AlpenglowIndustries/Alpenglow_SMTGarden_PCB/Alpenglow_SMTGarden_PCB/SMTSolderIntro.png

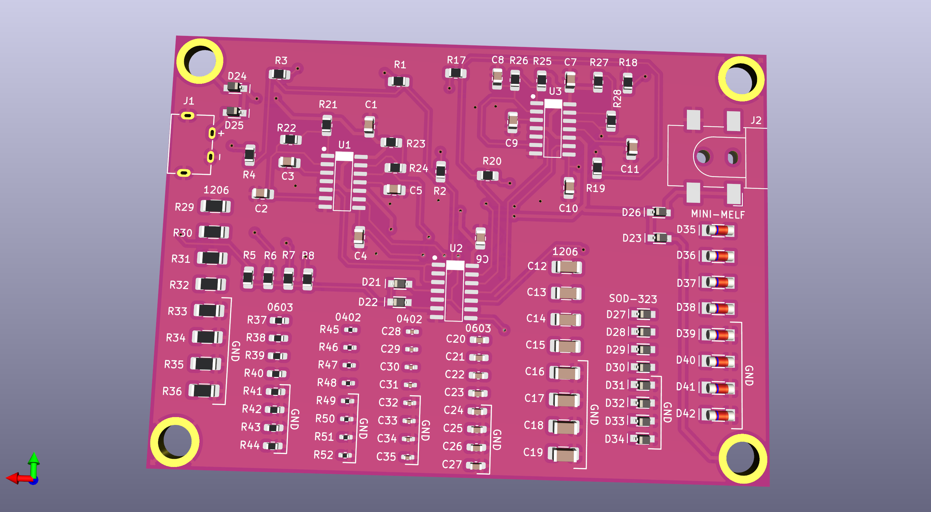
Alpenglow_SMTGarden_PCB/SMTSolderIntro.png
