AlpenglowIndustries/Alpenglow_SMTGarden_PCB/Alpenglow_SMTGarden_PCB/SMTSolderIntrofront.png

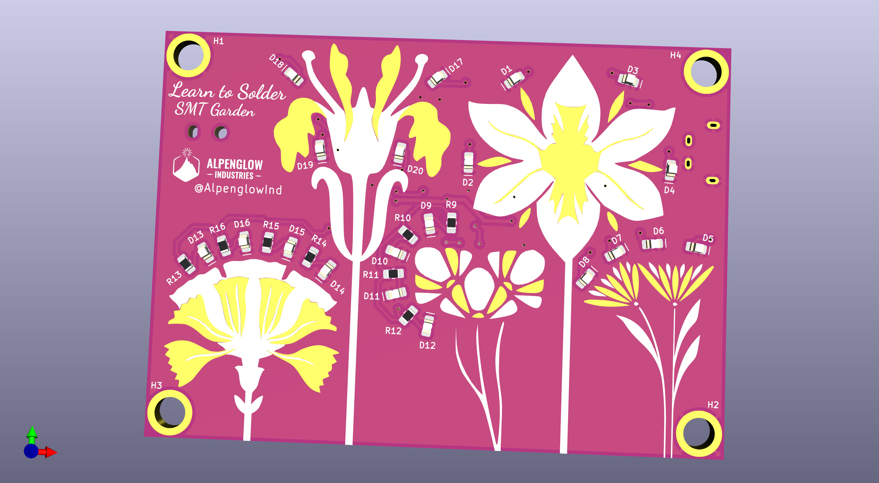
Alpenglow_SMTGarden_PCB/SMTSolderIntrofront.png
