AlpenglowIndustries/Alpenglow_SMTGarden_PCB/README.md

# Alpenglow_SMT_Soldering_PCB
A fun kit with lots of blinky lights and 555 timers that gives you lots of practice with different sizes of surface mount components
