AlpenglowIndustries/Alpenglow_SMTGarden_PCB/Artwork/My Exports/04Flower.png

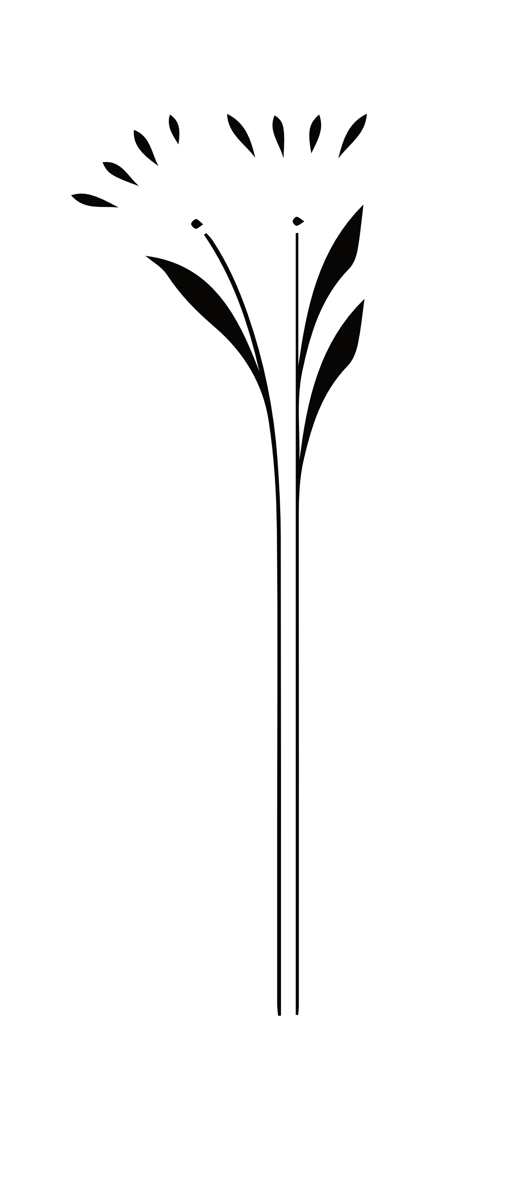
Artwork/My Exports/04Flower.png
