AlpenglowIndustries/Alpenglow_SMTGarden_PCB/Artwork/My Exports/04Inside.png

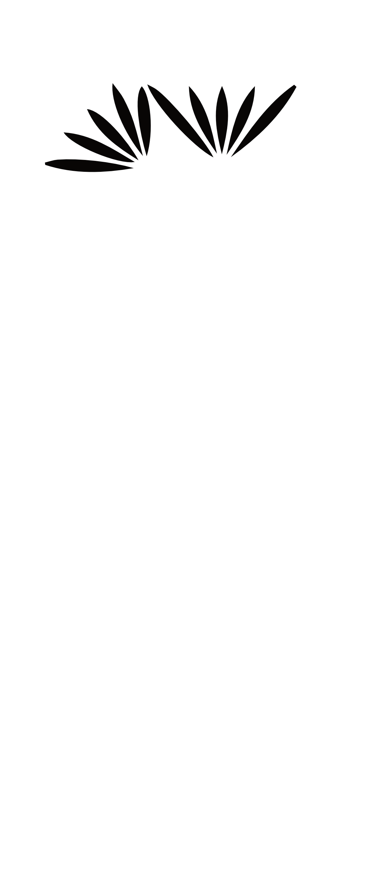
Artwork/My Exports/04Inside.png
