AlpenglowIndustries/Alpenglow_SMTGarden_PCB/Artwork/PNG/pngArtboard 2.png

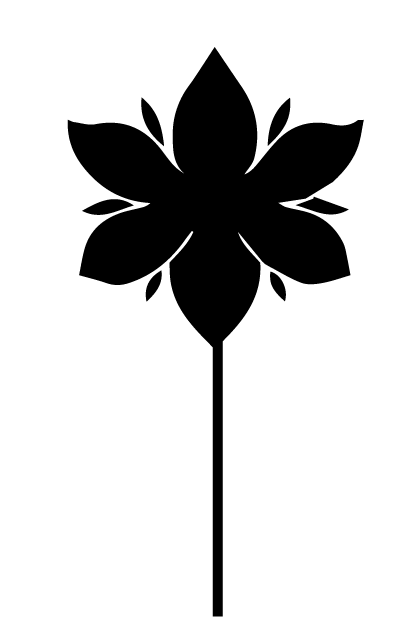
Artwork/PNG/pngArtboard 2.png
