AlpenglowIndustries/Alpenglow_SMTGarden_PCB/Artwork/PNG/pngArtboard 2_1.png

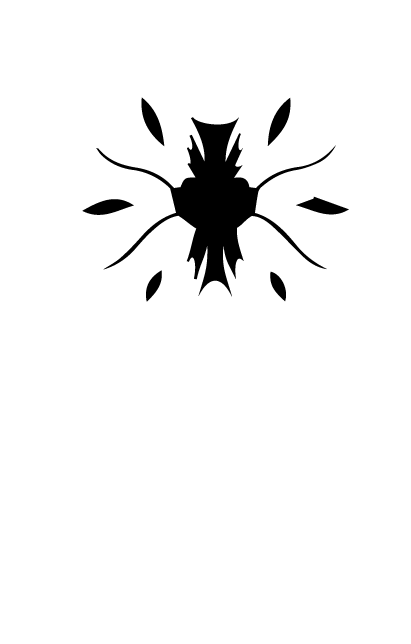
Artwork/PNG/pngArtboard 2_1.png
