AlpenglowIndustries/Alpenglow_SMTGarden_PCB/Artwork/PNG/pngArtboard 9.png

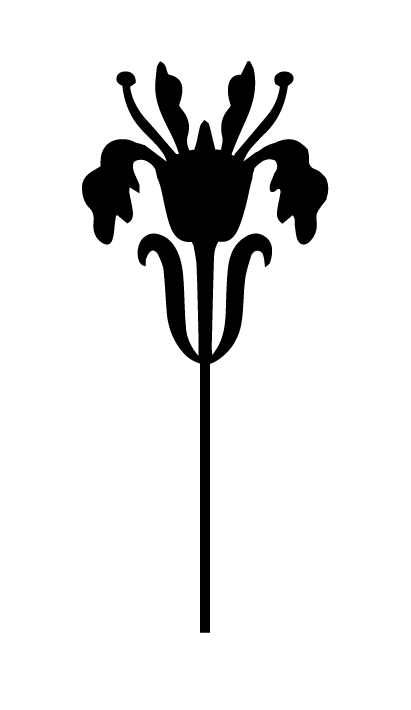
Artwork/PNG/pngArtboard 9.png
