AlpenglowIndustries/Alpenglow_SMTGarden_PCB/Artwork/PNG/pngArtboard 9_1.png

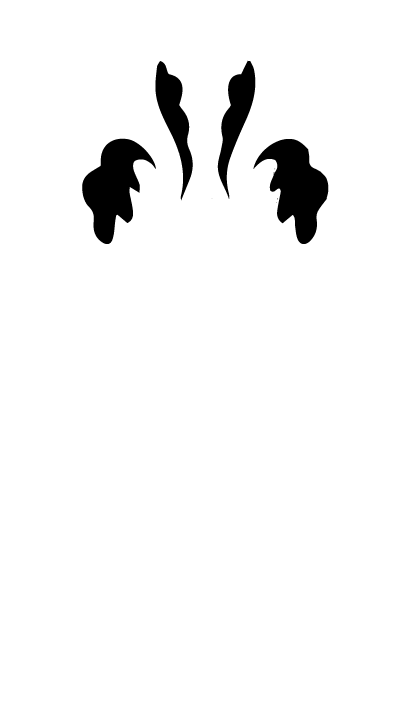
Artwork/PNG/pngArtboard 9_1.png
