AlpenglowIndustries/Alpenglow_SMTGarden_PCB/Artwork/PNG/pngArtboard 9_2 crop.png

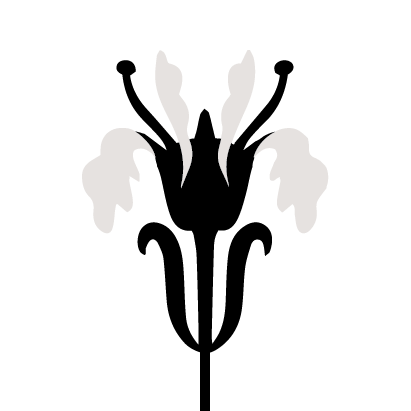
Artwork/PNG/pngArtboard 9_2 crop.png
