AlpenglowIndustries/Alpenglow_SMTGarden_PCB/Artwork/PNG/pngArtboard 9_3.png

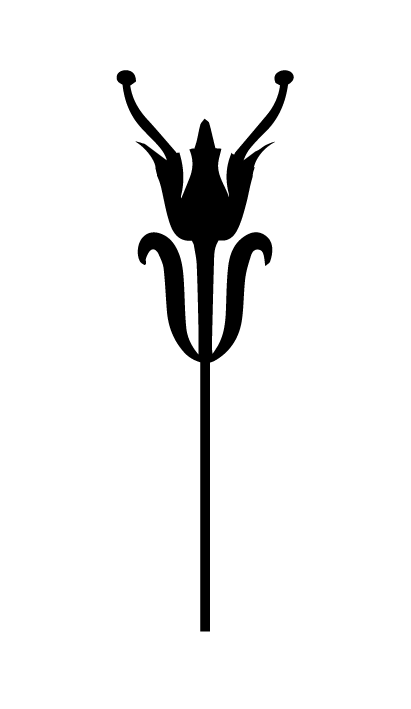
Artwork/PNG/pngArtboard 9_3.png
