AlpenglowIndustries/Alpenglow_SMTGarden_PCB/Artwork/PNG/pngArtboard 13.png

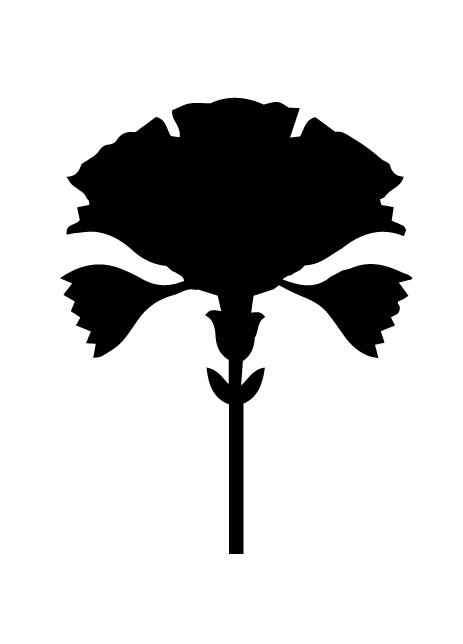
Artwork/PNG/pngArtboard 13.png
