AlpenglowIndustries/Alpenglow_SMTGarden_PCB/Artwork/PNG/pngArtboard 13_1.png

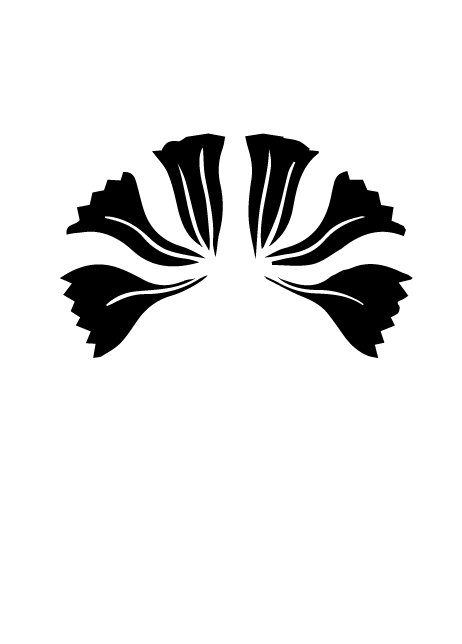
Artwork/PNG/pngArtboard 13_1.png
