AlpenglowIndustries/Alpenglow_SMTGarden_PCB/Artwork/PNG/pngArtboard 13_2.png

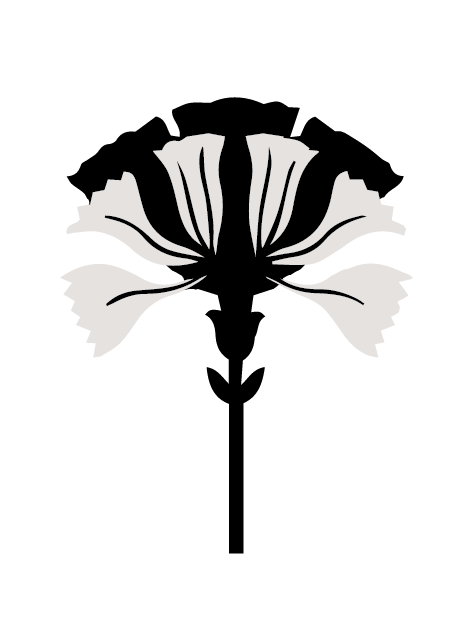
Artwork/PNG/pngArtboard 13_2.png
