AlpenglowIndustries/Alpenglow_SMTGarden_PCB/Artwork/PNG/pngArtboard 17.png

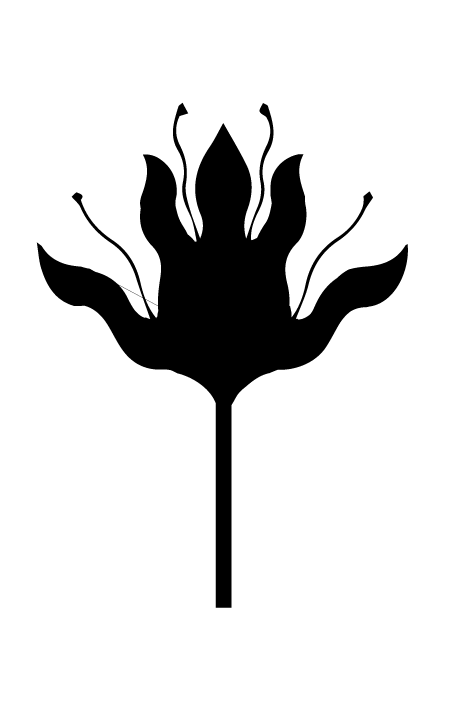
Artwork/PNG/pngArtboard 17.png
