AlpenglowIndustries/Alpenglow_SMTGarden_PCB/Artwork/PNG/pngArtboard 17_1.png

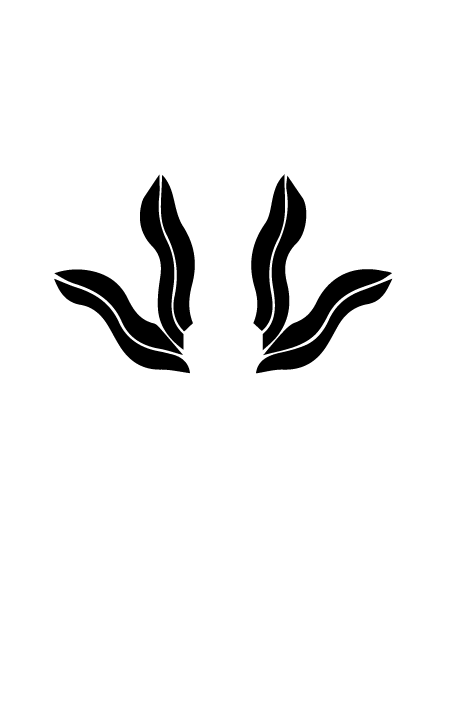
Artwork/PNG/pngArtboard 17_1.png
