AlpenglowIndustries/Alpenglow_SMTGarden_PCB/Artwork/PNG/pngArtboard 21.png

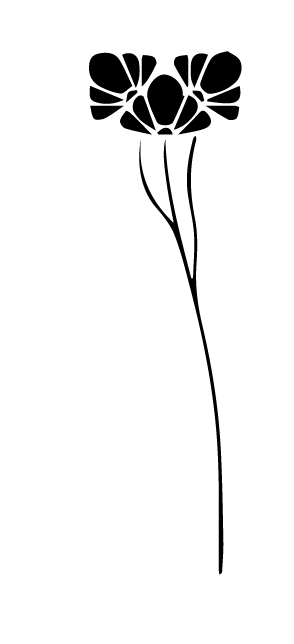
Artwork/PNG/pngArtboard 21.png
