AlpenglowIndustries/Alpenglow_SMTGarden_PCB/Artwork/PNG/pngArtboard 21_1.png

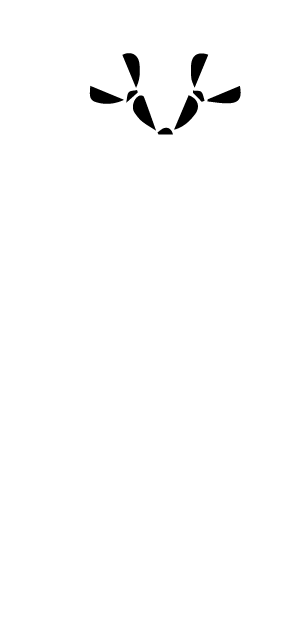
Artwork/PNG/pngArtboard 21_1.png
