AlpenglowIndustries/Alpenglow_SMTGarden_PCB/Artwork/Practice Stalks Dancing.png

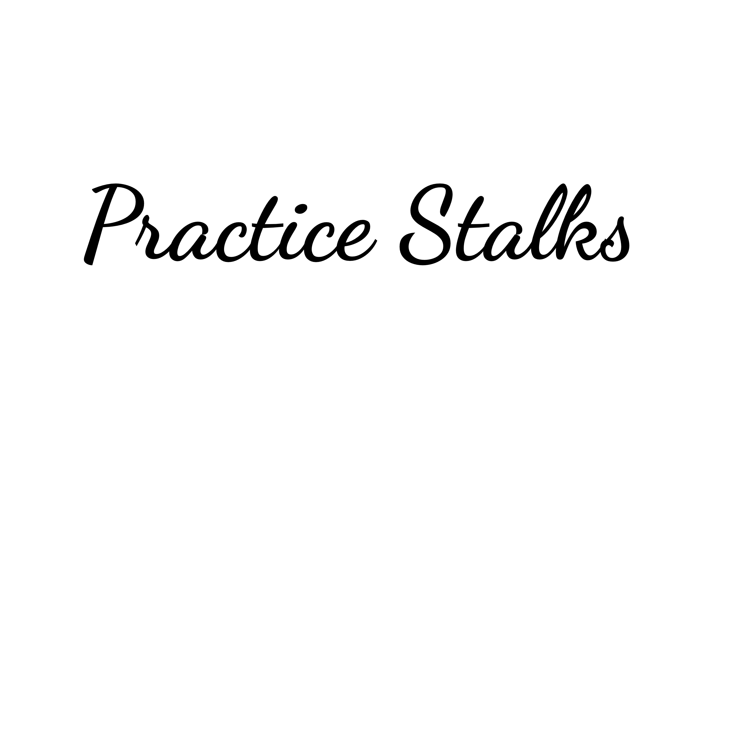
Artwork/Practice Stalks Dancing.png
