AlpenglowIndustries/Alpenglow_SMTGarden_PCB/Artwork/SMT Garden Dancing.png

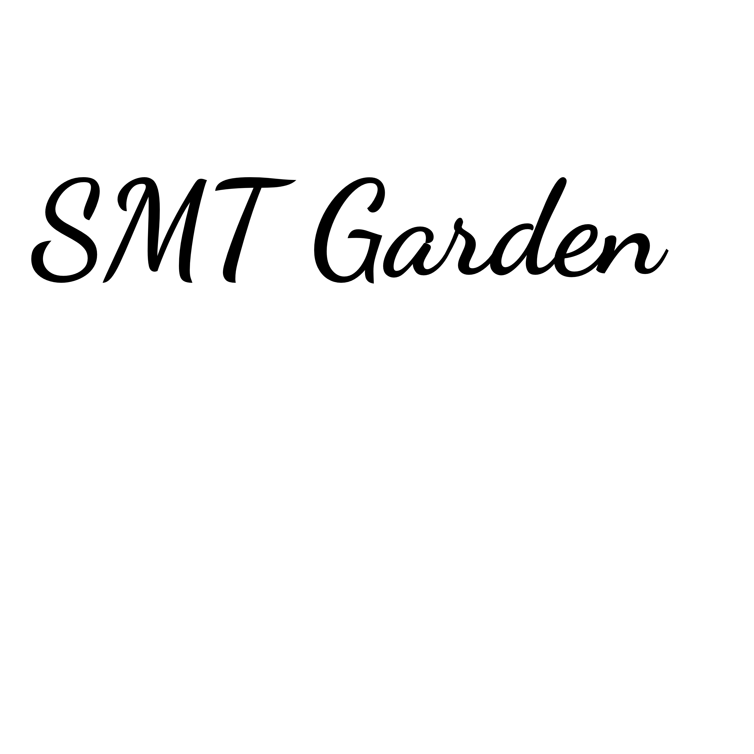
Artwork/SMT Garden Dancing.png
