AlpenglowIndustries/Alpenglow_SMTGarden_PCB/Screenshots/Back2.JPG

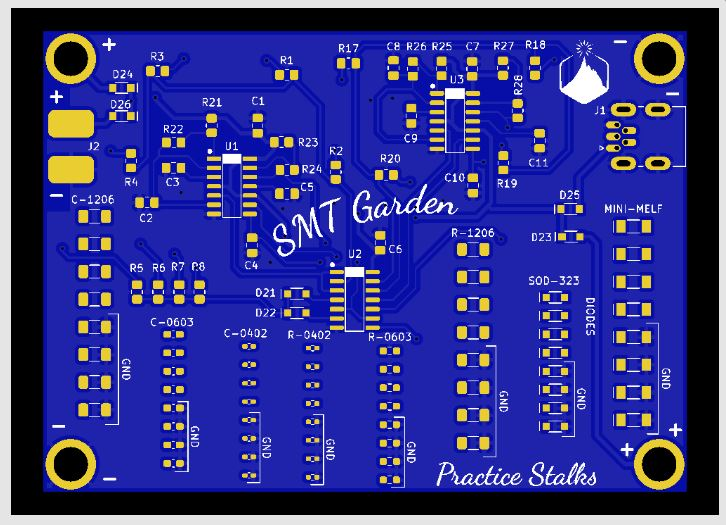
Screenshots/Back2.JPG
