AlpenglowIndustries/Alpenglow_SMTGarden_PCB/Screenshots/Front2.JPG

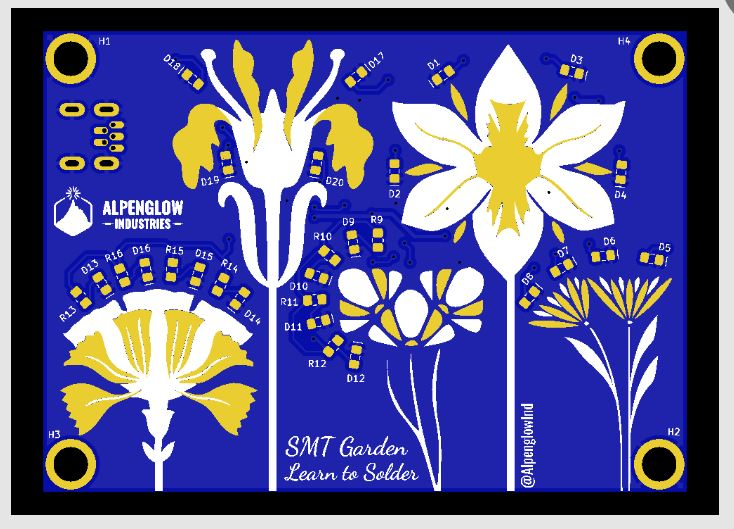
Screenshots/Front2.JPG
