AlpenglowIndustries/Alpenglow_SMTGarden_PCB/Screenshots/Front.JPG

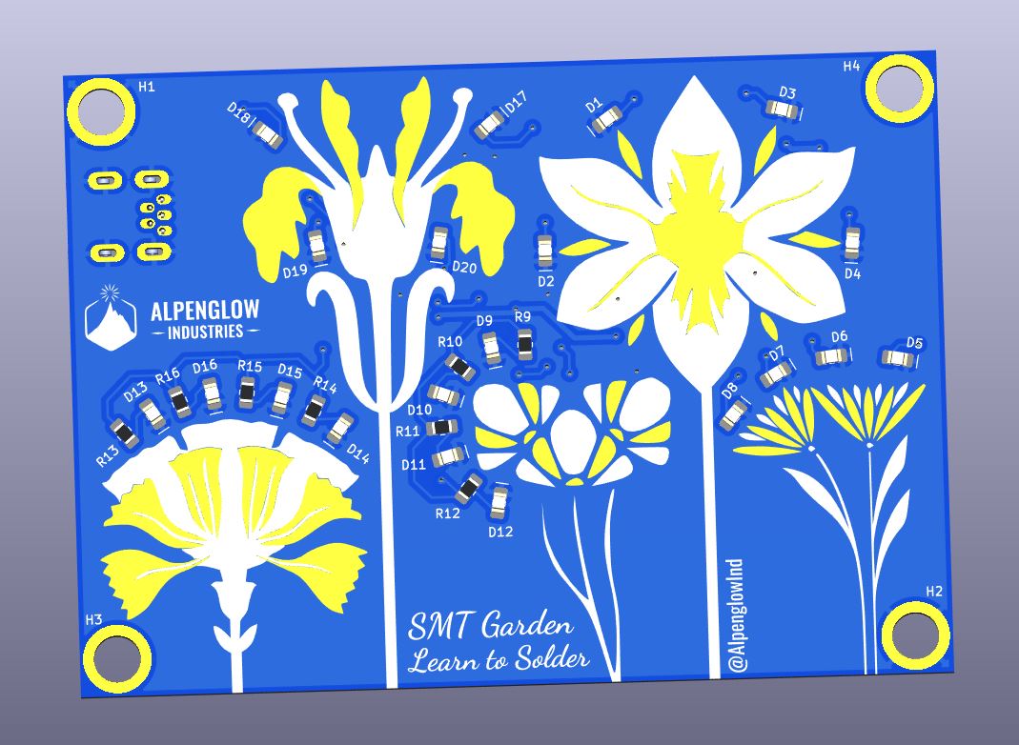
Screenshots/Front.JPG
