AlpenglowIndustries/Alpenglow_SMTGarden_PCB/Alpenglow_SMTGarden_PCB/AlpenglowSMTGarden Schematic.pdf

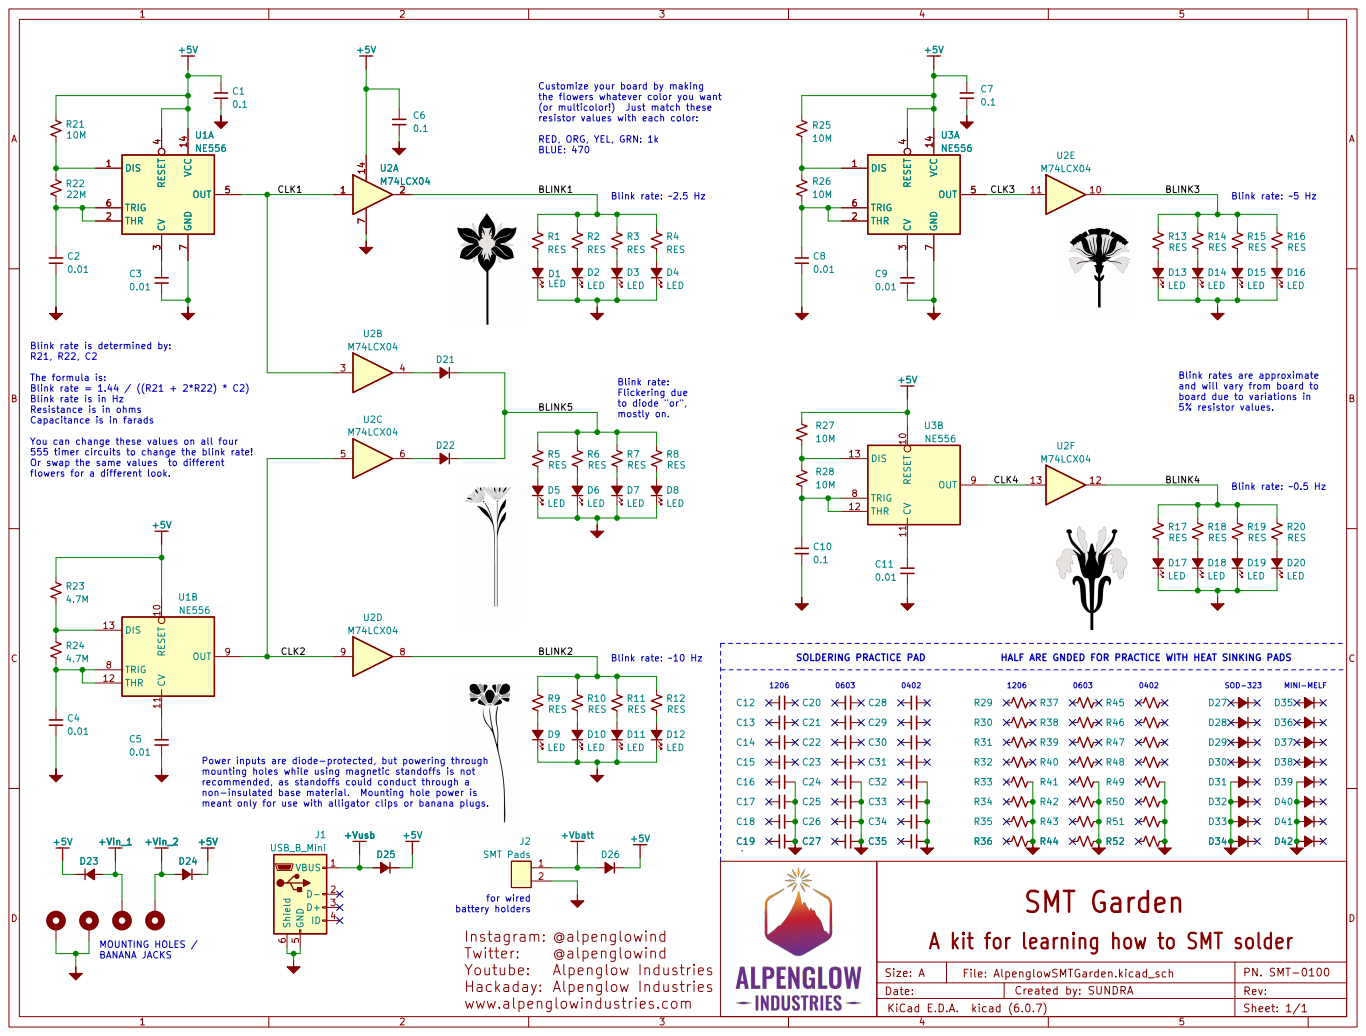
[picture p25: page 1]

Customize your board by making
the flowers whatever color you want
(or multicolor!) Just match these

Blink rate: ~5 Hz Blink rate: ~10 Hz Power inputs are diode-protected, but powering through

Blink rate is determined by: R21, R22, C2 The formula is: Blink rate = 1.44 / ((R21 + 2*R22) * C2) Blink rate is in Hz Resistance is in ohms Capacitance is in farads

Blink rates are approximate
and will vary from board to
board due to variations in 5% resistor values.

You can change these values on all four
555 timer circuits to change the blink rate!
Or swap the same values to different

mounting holes while using magnetic standoffs is not
recommended, as standoffs could conduct through a
non-insulated base material. Mounting hole power is

Alpenglow Industries A kit for learning how to SMT solder
