AlpenglowIndustries/Alpenglow_SMTGarden_PCB/Alpenglow_SMTGarden_PCB/Alpenglow SMT Garden Assembly Drawings/SMT Garden Assembly Drawing BOTTOM.pdf

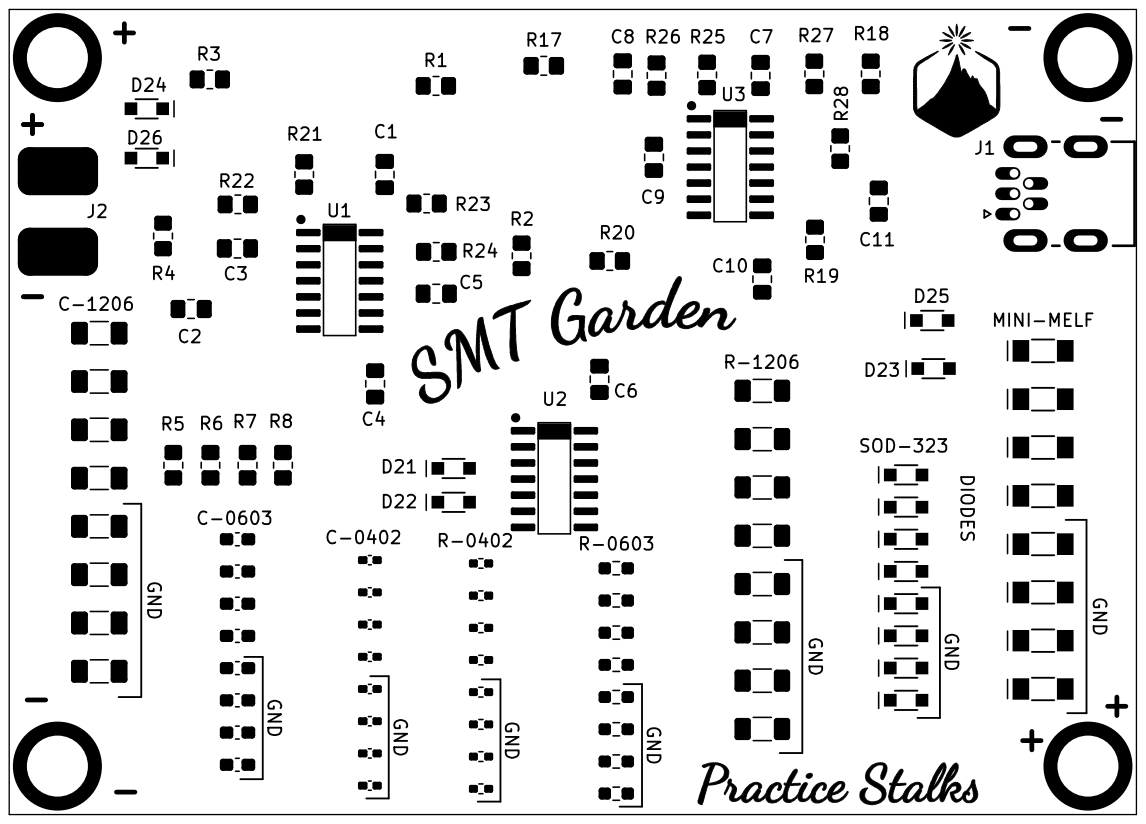
[picture p26: page 1]
