AlpenglowIndustries/Alpenglow_SMTGarden_PCB/Alpenglow_SMTGarden_PCB/Alpenglow SMT Garden Assembly Drawings/SMT Garden Assembly Drawing TOP.pdf

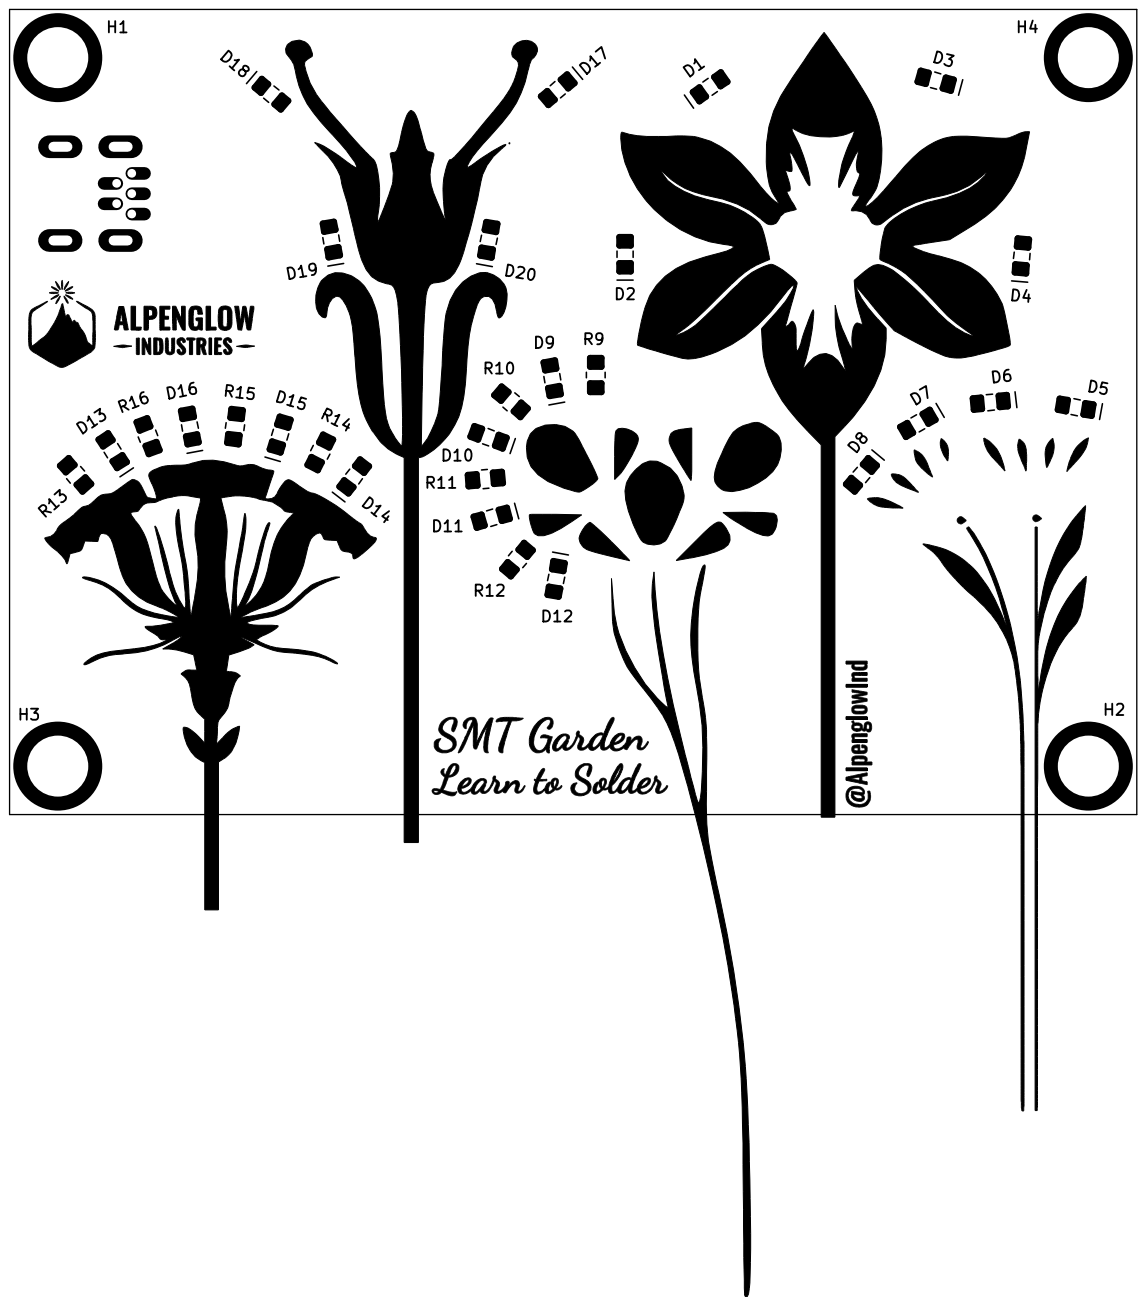
[picture p27: page 1]
