AlpenglowIndustries/Alpenglow_SMTGarden_PCB/Artwork/Learn to SMT Solder Dancing.png

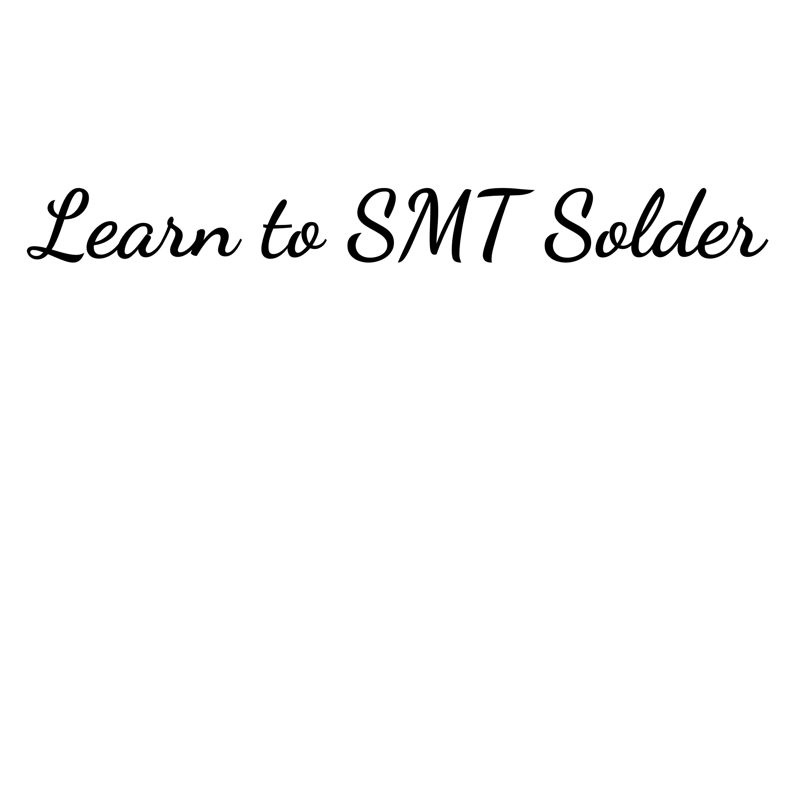
Artwork/Learn to SMT Solder Dancing.png
