AlpenglowIndustries/Alpenglow_SMTGarden_PCB/Artwork/Learn to SMT Solder Parisienne.png

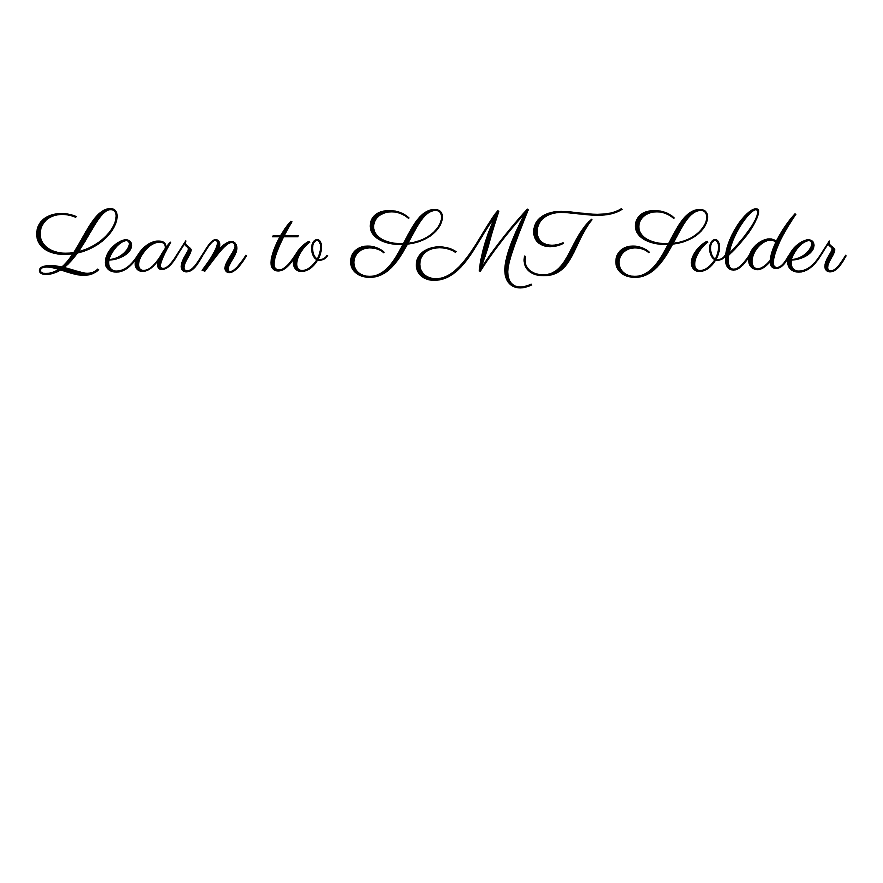
Artwork/Learn to SMT Solder Parisienne.png
