AlpenglowIndustries/Alpenglow_SMTGarden_PCB/Artwork/Learn to SMT Solder Yellowtail.png

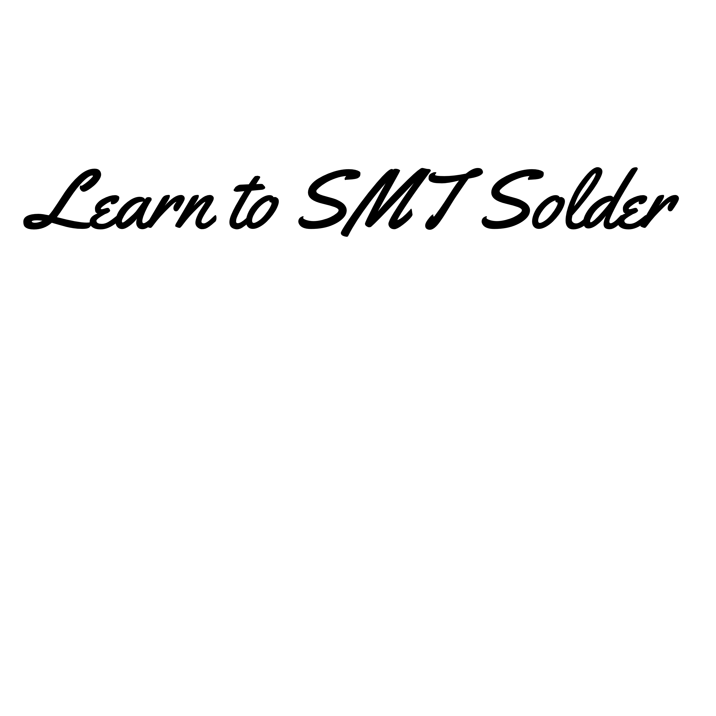
Artwork/Learn to SMT Solder Yellowtail.png
