AlpenglowIndustries/Alpenglow_SMTGarden_PCB/Artwork/Learn to Solder Dancing.png

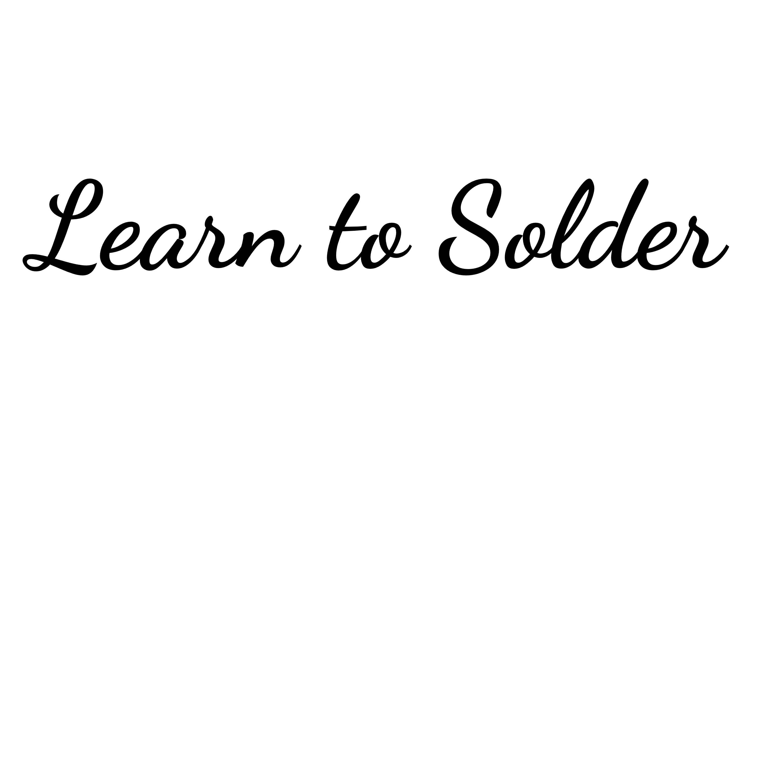
Artwork/Learn to Solder Dancing.png
