AlpenglowIndustries/Alpenglow_SMTGarden_PCB/(commit log)

2022-05-09 first draft of schematic, all parts on it, needs annotation and erc
    [SMTSolderIntro.kicad_pcb, SMTSolderIntro.kicad_sch]
2022-05-09 All components imported to board, nets still need work
    [SMTSolderIntro.kicad_pcb, SMTSolderIntro.kicad_sch]
2022-05-09 fixed nets and components with bad footprints. Ready for checking with printer.
    [SMTSolderIntro.kicad_pcb, SMTSolderIntro.kicad_sch]
2022-05-10 Rough placement, added zip files to ignore
    [SMTSolderIntro.kicad_pcb, SMTSolderIntro.kicad_sch]
2022-05-10 finished "flower" parts placement, created sch pdf
    [SMTSolderIntro.kicad_pcb]
2022-06-20 Added artwork. Started moving things around for layout
    [SMTSolderIntro.kicad_pcb, SMTSolderIntro.kicad_sch]
2022-06-20 Artwork layout. Saving here before moving components around
    [SMTSolderIntro.kicad_pcb]
2022-06-20 Fisrt Draft of artwork and component layout
    [SMTSolderIntro.kicad_pcb]
2022-06-21 Component layout and routing traces
    [SMTSolderIntro.kicad_pcb]
2022-06-22 Adjusted refrence designators
    [SMTSolderIntro.kicad_pcb]
2022-06-27 Updated layout, Labeled practice component sizes, Added board name, Updated Schematic
    [SMTSolderIntro.kicad_pcb, SMTSolderIntro.kicad_sch]
2022-06-27 changed some practice area positions & text sizes
    [SMTSolderIntro.kicad_pcb]
2022-06-28 Moved practice resistors and capacitors, Added words on back
    [SMTSolderIntro.kicad_pcb]
2022-06-28 spread out logo & text so more attention is on flowers
    [SMTSolderIntro.kicad_pcb]
2022-07-22 added some cap values, small sch changes for readability
    [SMTSolderIntro.kicad_sch]
2022-07-23 finalized 556 timer resistor and cap values for different flashing freqs, added some notes to the schematic, added flower images (will replace with better ones)
    [SMTSolderIntro.kicad_sch]
2022-07-23 Renamed project, sch, and pcb to AlpenglowSMTGarden
    [AlpenglowSMTGarden.kicad_pcb, AlpenglowSMTGarden.kicad_sch]
2022-07-23 renamed folder
    [AlpenglowSMTGarden.kicad_pcb, AlpenglowSMTGarden.kicad_sch]
2022-07-24 changed resistor value for U1A timer
    [AlpenglowSMTGarden.kicad_sch]
2022-07-26 updated schematic template, values for some 555 clocks, and flower images, added todo notes on PCB
    [AlpenglowSMTGarden.kicad_pcb, AlpenglowSMTGarden.kicad_sch]
2022-08-10 changed USB-C to mini B through hole, changed barrel jack to SMT pads, embiggened logos and text, added mounting hole power caution note to schematic.
    [AlpenglowSMTGarden.kicad_pcb, AlpenglowSMTGarden.kicad_sch]
2022-09-25 minor changes to text, generated gerbers and screenshots
    [AlpenglowSMTGarden-B_Cu.gbr, AlpenglowSMTGarden-B_Mask.gbr, AlpenglowSMTGarden-B_Paste.gbr, AlpenglowSMTGarden-B_Silkscreen.gbr, AlpenglowSMTGarden-Edge_Cuts.gbr, AlpenglowSMTGarden-F_Cu.gbr, AlpenglowSMTGarden-F_Mask.gbr, AlpenglowSMTGarden-F_Paste.gbr]
2022-10-11 updated pdf schematic export
2022-10-26 Assembly drawings, schematic, BOM
    [SMT Garden BOM Instructions.xlsx]
2022-10-27 updated BOM
    [SMT Garden BOM Instructions.xlsx]
2022-10-27 Updated gitignore, changed BOM to CSV file
    [SMT Garden BOM Instructions.csv, SMT Garden BOM Instructions.xlsx]
